postech-psi/TMS/Data/2025/6_16/6_16 calidata.png

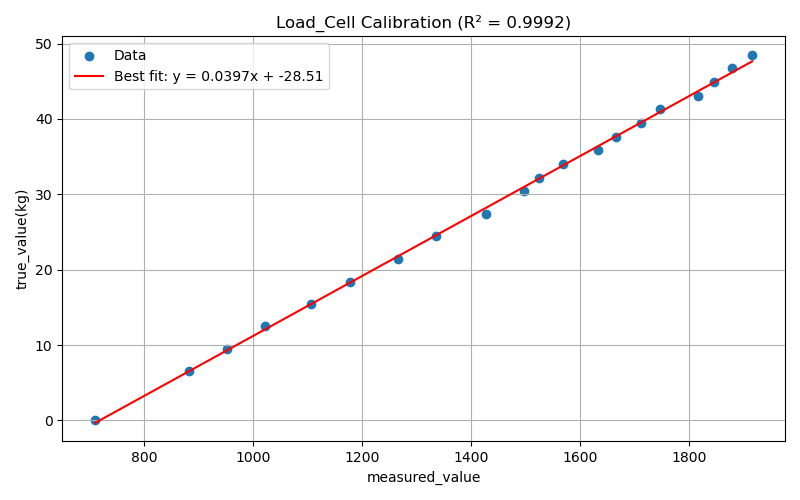
Data/2025/6_16/6_16 calidata.png
