postech-psi/TMS/Data/2025/6_16/tms_figure.png

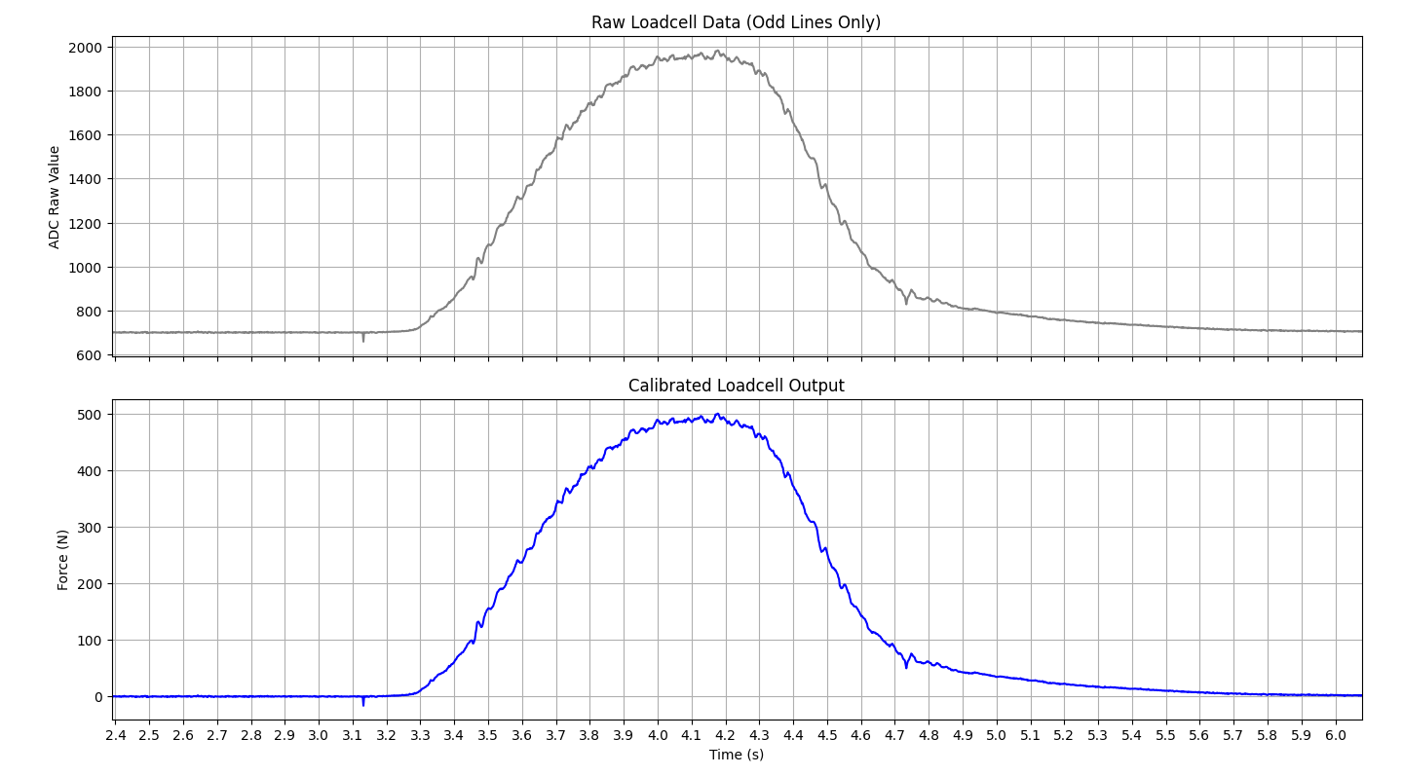
Data/2025/6_16/tms_figure.png
