postech-psi/TMS/Data/2025/11_27/11_27 positive calidata.png

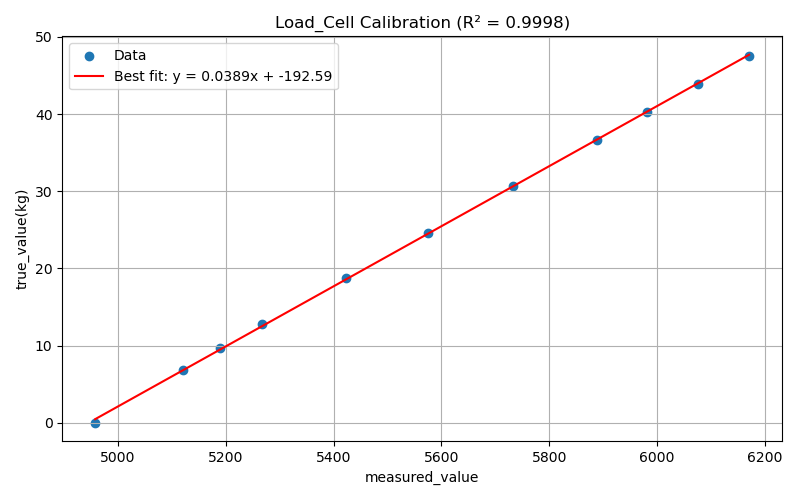
Data/2025/11_27/11_27 positive calidata.png
