postech-psi/TMS/Data/2025/11_27/analysis_output/thrust_curve.png

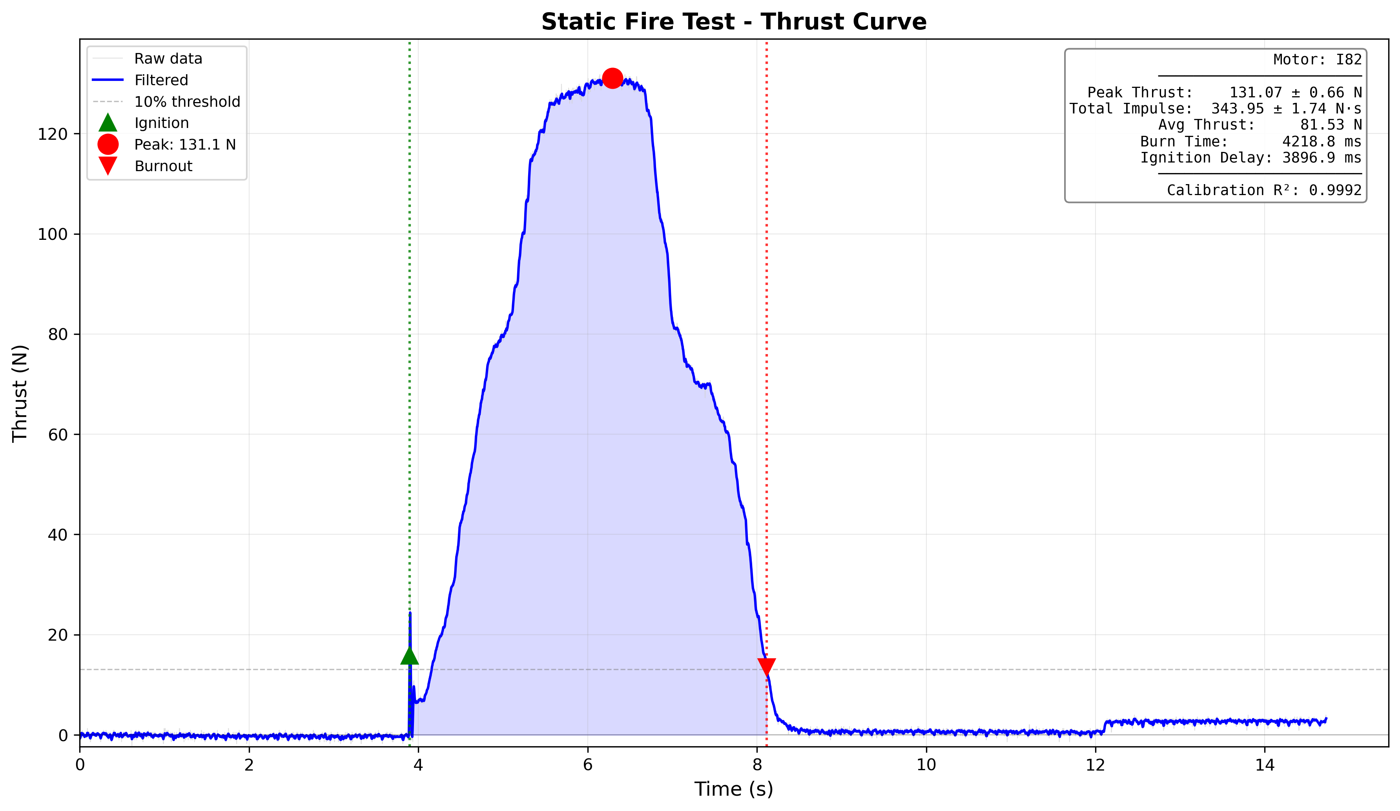
Data/2025/11_27/analysis_output/thrust_curve.png
