postech-psi/TMS/Data/2025/11_27/analysis_output/tms_analysis_plot.png

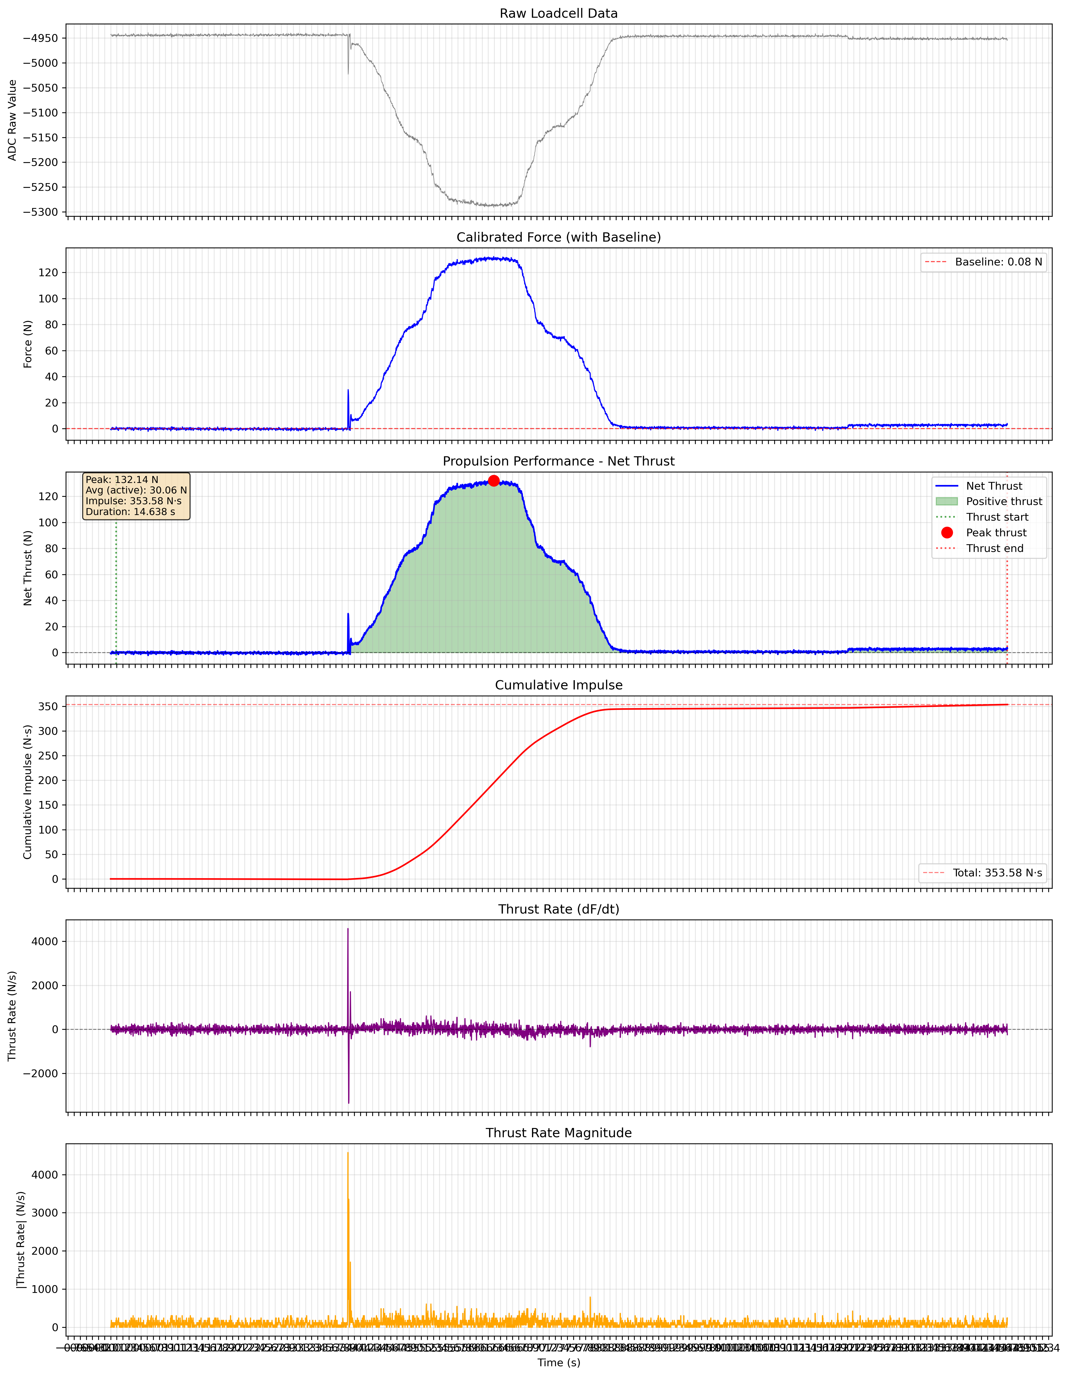
Data/2025/11_27/analysis_output/tms_analysis_plot.png
