postech-psi/TMS/Data/2026/4_2/cali_baro.png

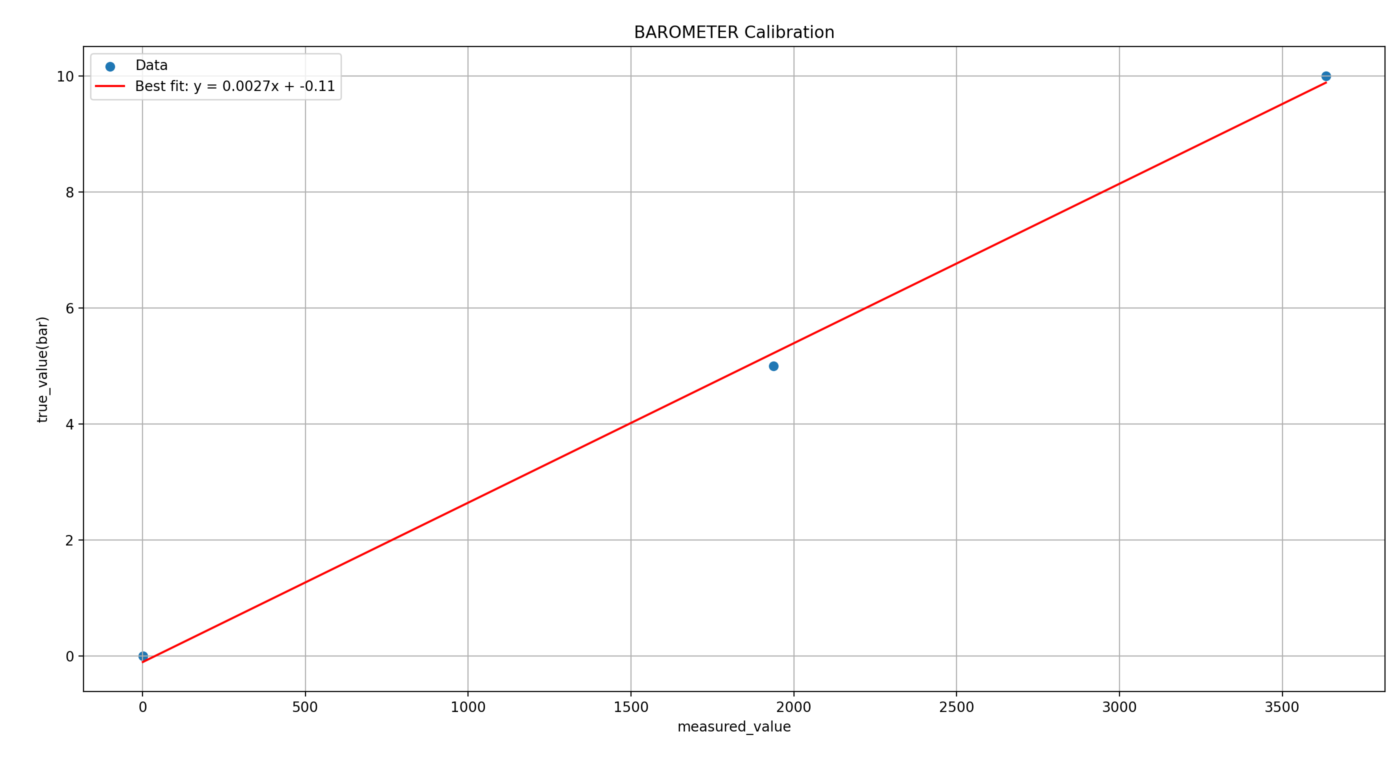
Data/2026/4_2/cali_baro.png
