postech-psi/TMS/Data/2026/4_8/analysis/2026.04.08 data_barometer_plot.png

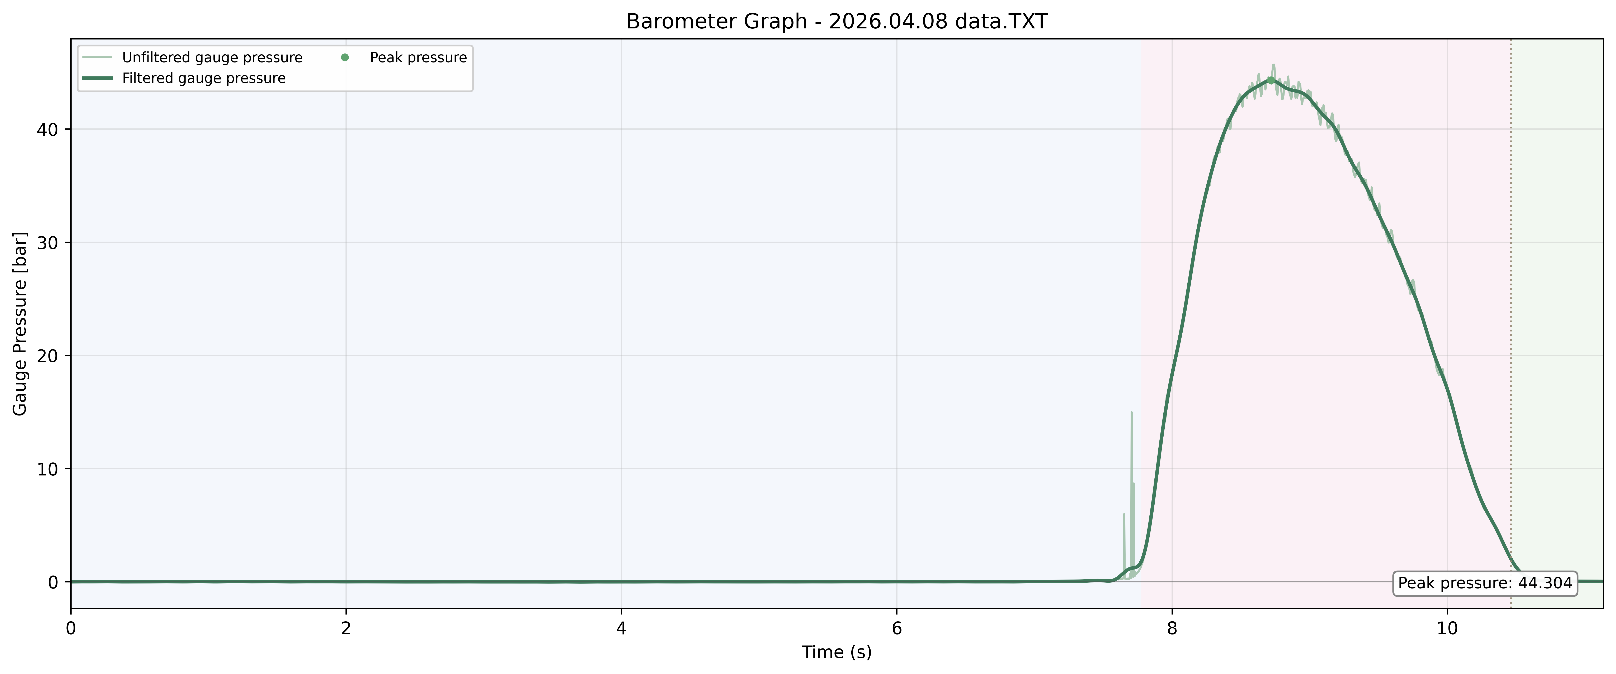
Data/2026/4_8/analysis/2026.04.08 data_barometer_plot.png
