postech-psi/TMS/Data/2026/5_28/analysis/2026.05.28 data_loadcell_plot.png

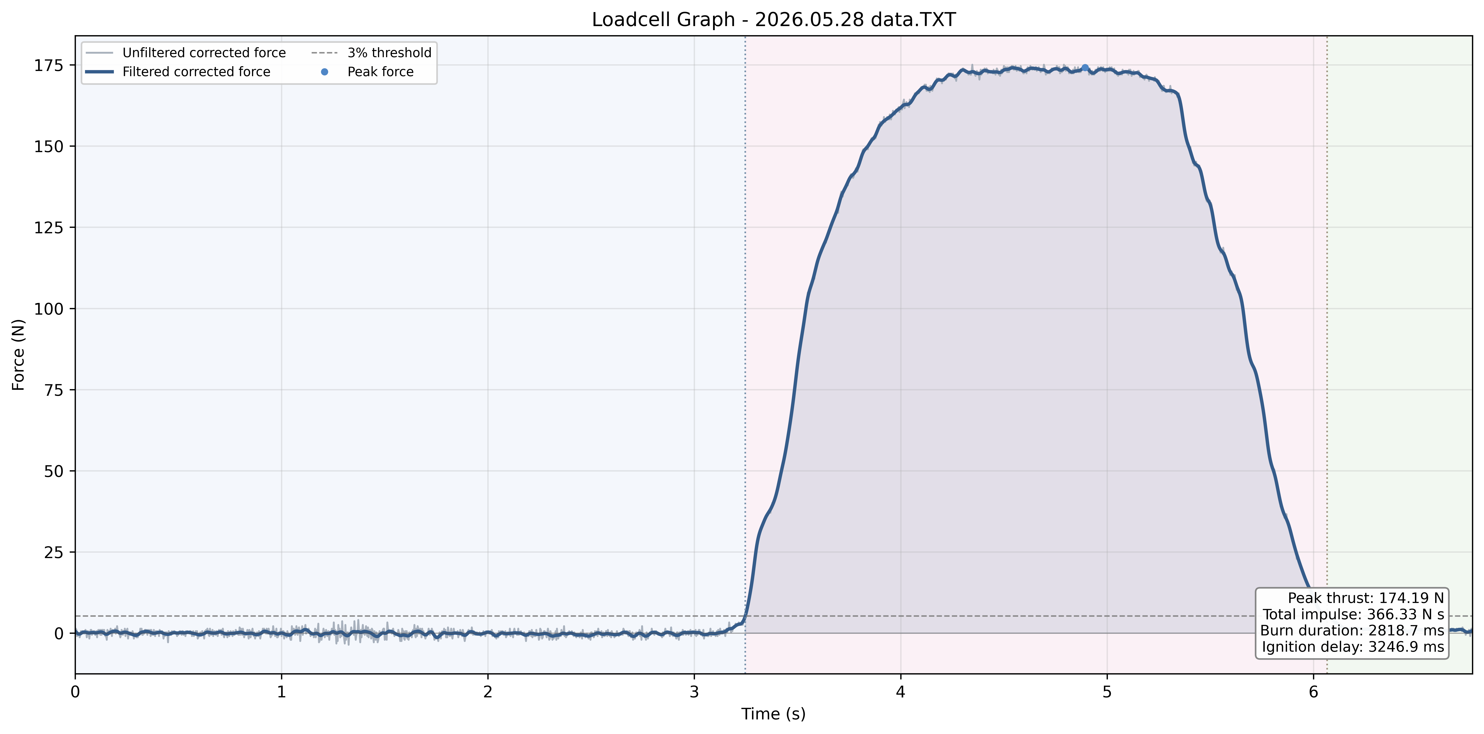
Data/2026/5_28/analysis/2026.05.28 data_loadcell_plot.png
