postech-psi/TMS/Data/2026/7_16/analysis/2026.07.16 data_combined_plot.png

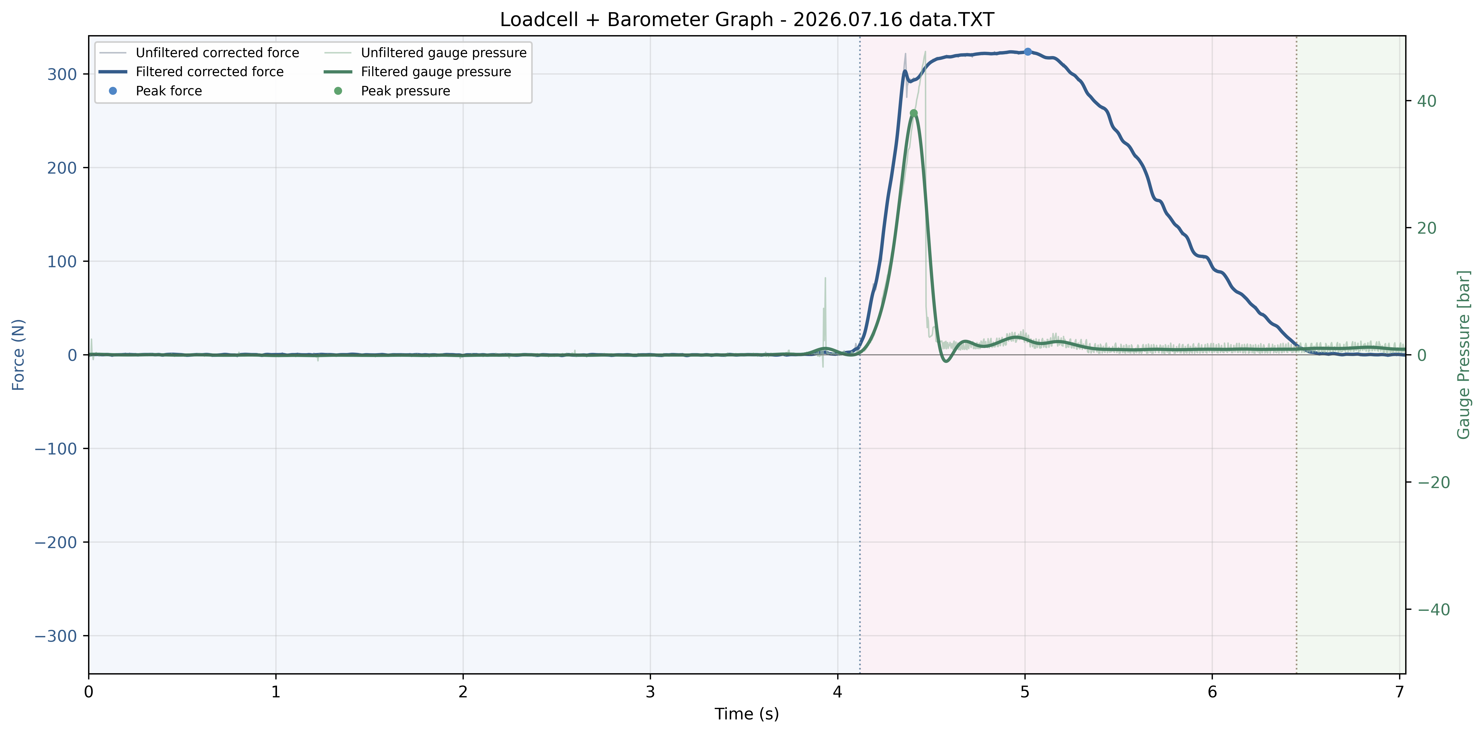
Data/2026/7_16/analysis/2026.07.16 data_combined_plot.png
