postech-psi/TMS/Data/2026/10_13/analysis/2026-10-13_tms-5_combined_plot.png

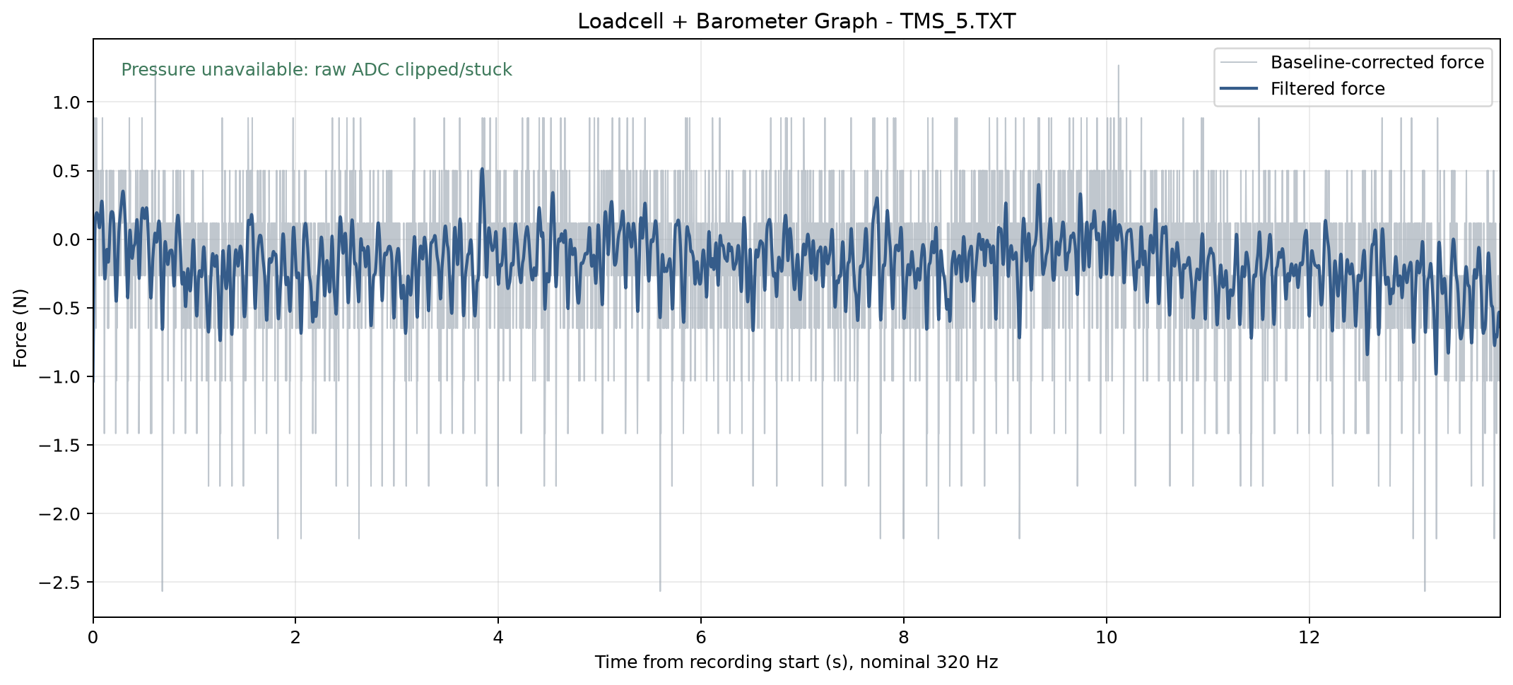
Data/2026/10_13/analysis/2026-10-13_tms-5_combined_plot.png
