postech-psi/TMS/Data/2026/10_13/video/2026-10-13_tms-4_video_poster.jpg

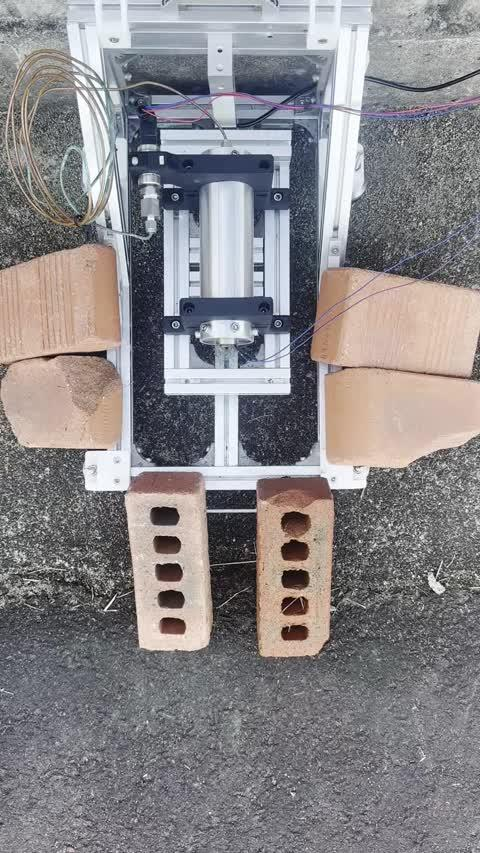
Data/2026/10_13/video/2026-10-13_tms-4_video_poster.jpg
