postech-psi/TMS/(commit log)

2025-11-27 add calibration code
    [calibtaration data.csv]
2025-11-28 호호호호호호
2026-02-10 tms data updates
    [barometer data 표준편차.xlsx, pressure1.xlsx, summary_metrics.csv, test1.xlsx, test2.xlsx, test3.xlsx]
2026-03-27 주석 수정
    [barometer data 표준편차.xlsx, pressure1.xlsx, summary_metrics.csv, test1.xlsx, test2.xlsx, test3.xlsx]
2026-04-03 pipeline update & power on capture
2026-04-03 interrupt handling change & timestamp update
2026-04-03 Update calibration pipeline and 2026-04-03 analysis outputs
2026-10-13 Fix TMS recording parsing and reject invalid pressure measurements
2026-10-13 Use consistent sensor plot titles without channel status labels
2026-10-13 Reprocess October thrust with pre-tail decay extrapolation
